kudryavtsevov/VM_T1/README.md

# VM-T1 F1Q — ESP32-C3 Super Mini

Отдельная ветка **`f1q-esp32-c3-super-mini`** для недорогого открытого таймера F1Q.
Исходный проект таймера — **Мстислав**, опубликован с его разрешения под Apache-2.0.
Основная ветка `main` сохраняет исходный проект ESP32-S3; эта ветка использует другую распиновку и логику старта.

## Что подготовлено

- ESP32-C3 Super Mini устанавливается на плату двумя рядами по 8 контактов, шаг 2,54 мм, междурядье 15,24 мм.
- Три сервопривода, отдельный ESC, кнопки ARM/START/OFF/RC DT.
- INA226: ток, напряжение, энергия; BMP280: относительная высота и максимум.
- Экспериментальный лимиттер по энергии и времени с блокировкой повторного запуска.
- Настройка через Wi-Fi. Концевики BACK/FRONT в F1Q не используются.

**Для двигателя около 7 А нужно физически заменить R100 на R010 (0,01 Ом, от 2 Вт).**
Рабочий предел 7,5 А, диапазон АЦП около 8,19 А. Пусковые пики и нагрев требуют стендового измерения.
Режим F1Q по умолчанию выключен. Это прототип, **одобрения EDIC и аппаратных испытаний нет**.

## Документация и плата

- [Размеры, ориентация двух рядов и GPIO C3](docs/C3_GEOMETRY.md).
- [Подключение R010, BMP280 и порядок испытаний](docs/F1Q.md).
- [Готовые модули в России](docs/BUY_RU.md).
- [KiCad, схема, Gerber и монтажный эскиз платы C3](hardware/c3-supermini-v1/README.md).
- [Лицензия и зависимости](LICENSING.md).

Старые PDF и `hardware/carrier-v1` относятся к исходному таймеру/S3 и не являются инструкцией для C3.

## Arduino IDE

Открыть `VM_T1/VM_T1.ino`. Папка и основной файл должны иметь одинаковое имя `VM_T1`.

1. В менеджер плат добавить `https://espressif.github.io/arduino-esp32/package_esp32_index.json`.
2. Установить **esp32 by Espressif Systems 2.0.11**.
3. Библиотеки: **ESP32Servo 1.1.2**, **ArduinoJson 7.4.3**, **Adafruit BMP280 Library 2.6.8**, **Adafruit BusIO 1.17.4**, **Adafruit Unified Sensor 1.1.15**.
4. Плата **ESP32C3 Dev Module**; USB CDC On Boot **Enabled**, Flash Mode **DIO**, Upload Speed **115200**. PSRAM для C3 не требуется.
5. Verify, затем выбрать порт и Upload. При необходимости входа в загрузчик удержать BOOT, нажать и отпустить RESET, затем отпустить BOOT.

```sh
arduino-cli compile --fqbn "esp32:esp32:esp32c3:CDCOnBoot=cdc,FlashMode=dio,UploadSpeed=115200" VM_T1
```

При включении со снятым ARM точка Wi-Fi работает три минуты. Повторно: снять ARM и держать OFF три секунды.
GPIO9/BOOT не занят периферией. Прошивка отклоняет сборку для S3, чтобы не прошить несовместимую распиновку.
Версии Core 3.x этой проверкой не подтверждены.

## Проверки

Arduino CLI 0.35.3: сборка C3 проверена — 806 276 байт Flash, 39 972 байта RAM. Подробности итоговых проверок — в `hardware/c3-supermini-v1/README.md`.
Автономные тесты расчёта энергии находятся в `tests/`. Проверка геометрии, назначения GPIO и совпадения схемы с платой — `tools/verify_c3.py`.
Проверки на компьютере не заменяют калибровку и испытания физического устройства.
