kudryavtsevov/VM_T1/LICENSING.md

# Лицензирование

Автор исходного проекта VM-T1 — **Мстислав**.
Подготовка к публикации выполняется с разрешения автора, о котором сообщил
сопровождающий репозитория. Выбранная лицензия — **Apache-2.0**.

Лицензия распространяется на исходный код и документацию этого проекта,
включая `VM_T1/VM_T1.ino`, `VM-T1_Руководство_пользователя.pdf`
и `Распайка.pdf`. Полный текст находится в [LICENSE](LICENSE),
сведения об авторстве — в [NOTICE](NOTICE).

Apache-2.0 допускает использование, изменение и продажу, включая закрытые
производные. При распространении необходимо соблюдать условия лицензии,
в том числе сохранять предусмотренные уведомления и обозначать изменения.
Лицензия не ограничивает цену готового устройства.

## Зависимости

В исходнике есть подключения библиотек, но сами библиотеки и точные версии не приложены.

- [Arduino Core for ESP32](https://github.com/espressif/arduino-esp32): основная лицензия LGPL-2.1; отдельные компоненты имеют собственные условия.
- [ESP32Servo](https://github.com/madhephaestus/ESP32Servo#license): LGPL-2.1-or-later.
- [ArduinoJson](https://arduinojson.org/): MIT.
- [Adafruit BMP280 Library](https://github.com/adafruit/Adafruit_BMP280_Library), 2.6.8: BSD, уведомление в исходниках библиотеки.
- [Adafruit Unified Sensor](https://github.com/adafruit/Adafruit_Sensor), 1.1.15: Apache-2.0.
- [Adafruit BusIO](https://github.com/adafruit/Adafruit_BusIO), 1.17.4: MIT.

Новые файлы прошивки, схема и плата-переходник распространяются под Apache-2.0. Библиотеки не включены в репозиторий; устанавливаются отдельно.

Apache-2.0 для проекта не отменяют условий зависимостей.
Перед распространением готовых бинарных прошивок нужно закрепить версии, проверить
лицензии реально включённых компонентов и обеспечить выполнение LGPL, в том числе
условий изменения/перелинковки библиотек. Это предварительная проверка, не полный
аудит бинарной сборки.

## Источник лицензии

[Официальный текст Apache License 2.0](https://www.apache.org/licenses/LICENSE-2.0.txt).
