kudryavtsevov/VM_T1/docs/BUY_RU.md

# Готовые модули и комплектующие в России

Ссылки проверялись в сентябре 2026; цена, наличие и комплектация меняются. Это платы-модули для Arduino/ESP32, не отдельные микросхемы.

| Что | Продавец | Что проверить |
|---|---|---|
| INA226 R100 | [Неглупый Дом](https://notshome.ru/?items=927) | готовый модуль с 0,1 Ом; для нашего двигателя заменить шунт |
| INA226 | [SMDX](https://smdx.ru/ina226) | название магазина SMDX не означает отдельную SMD-микросхему; уточнить шунт |
| INA226 | [AVRobot](https://www.avrobot.ru/product_info.php?products_id=7611) | вариант/наличие встроенного шунта уточнить |
| CJMCU-226 | [RoboParts](https://roboparts.ru/catalog/datchiki/datchiki_toka_i_napryazheniya/cjmcu-226-ina226/) | не полагаться на указанное «R100 до 8 А»: предел около 0,82 А |
| BMP280 3,3 В | [Элкотел](https://www.elcotel.ru/catalog/arduino/datchiki_i_moduli/139053/) | питание и подтяжки I²C 3,3 В |
| BMP280 Trema | [iArduino](https://iarduino.ru/shop/Sensory-Datchiki/barometr-trema-modul.html) | распиновка и адрес модуля |

Ваш INA226 уже есть: покупать другой не требуется, если его силовые контакты и дорожки пригодны для 7 А. Нужен R010 (10 мОм), не менее 2 Вт, 1% или точнее, с подходящим корпусом. Конкретный артикул замены пока не выбран: нужен размер установленного R100. Нельзя покупать по одной маркировке без проверки мощности и размера.

Также нужны ESP32-C3 Super Mini, BEC 5 В, ESC с совместимым сигналом 3,3 В, выводной резистор 47 кОм, кнопки START/OFF/RC DT, перемычка ARM, провода, плата-переходник. Для внешнего LED — резистор 1 кОм; для пищалки — модуль со своим драйвером. ESP вставляется в два разъёма 1×8 на плате C3; датчики подключаются короткими проводами и крепятся отдельно.
