kudryavtsevov/VM_T1/docs/F1Q.md

# INA226, BMP280 и экспериментальный режим F1Q

Версия 30 сентября 2026. Режим F1Q по умолчанию выключен. Исходный таймер — Мстислав; расширение датчиков и платы добавлено отдельно.

## Ваш модуль: заменить R100 на R010

Для заявленного двигателя около 7 А установленный R100 (0,1 Ом) непригоден: падение 0,7 В, мощность 4,9 Вт. INA226 измеряет только ±81,92 мВ. Это ограничение АЦП, а не калибровки.

По согласованному варианту замените R100 на **R010, 0,01 Ом, 1% или точнее, не менее 2 Вт**, подходящего размера. Размер и допустимую мощность определяют по конкретному резистору: маркировка R010 сама по себе их не задаёт. Уточните посадочное место перед покупкой. Замена потребует пайки одного SMD-резистора на готовом модуле; сама плата-переходник — выводная.

При 7 А: падение 70 мВ, нагрев 0,49 Вт. Теоретический предел — 8,192 А, программный рабочий предел — 7,5 А и 75 мВ. Проверить нужно полный ток, включая электронику и сервоприводы. Если пусковые пики превышают диапазон, нужен другой шунт и пересмотр калибровки. **С оставленным R100 новая прошивка будет завышать ток в 10 раз. Не включайте F1Q до физической замены.**

Основание: [INA226, документация TI](https://www.ti.com/lit/ds/symlink/ina226.pdf). Сведения продавцов «R100 до 8 А» не соответствуют этому диапазону АЦП.

## Подключение

Прошивка рассчитана на ESP32-C3 Super Mini. Питание датчиков и подтяжек I²C — **3,3 В**, общая земля, SDA GPIO2, SCL GPIO10. INA226: адрес 0x40; BMP280: 0x76 или 0x77, именно BMP280 (ID 0x58), не BME280. CSB у BMP280 должен быть подтянут к 3,3 В для I²C; на готовых модулях проверить перемычки/схему.

Силовая цепь: аккумулятор + → IN+ / R010 / IN− → ESC и вход BEC. Минус аккумулятора общий с ESC, BEC, ESP и датчиками. VBUS INA226 должен измерять **IN−**, нагрузочную сторону: программа добавляет падение на шунте для восстановления напряжения аккумулятора. Сначала проверьте прозвонкой заводское соединение VBUS; не перемыкайте IN+ и IN− через заводские дорожки. Силовые провода припаиваются к подходящим силовым контактам, не к гребёнке Dupont. Способность дорожек и контактов именно вашего модуля выдержать 7 А требуется проверить.

Ток двигателя через плату-переходник не проходит. BEC 5 В питает ESP и сервоприводы. Аккумулятор напрямую к 5V/3V3 подключать нельзя. Пока поддержаны измеряемые напряжения 1–16 В; для 4S полностью заряженных 16,8 В этот вариант не подходит. Не подключать одновременно USB и внешние 5 В к ESP32-C3 Super Mini без развязки источников.

| Сигнал | GPIO | Подключение |
|---|---:|---|
| Servo S/R/W | 4 / 5 / 6 | сигнал; питание от BEC |
| RC DT / OFF | 7 / 20 | замыкание на GND |
| START / ARM | 1 / 0 | кнопка / съёмная перемычка на GND |
| ESC | 3 | сигнал, общий GND; резистор 47 кОм на GND |
| Buzzer | 21 | управляющий вход модуля с драйвером |
| LED | 8 | встроенный синий, активный LOW |
| SDA / SCL | 2 / 10 | оба датчика параллельно |

[Геометрия и ориентация ESP32-C3 Super Mini](C3_GEOMETRY.md): два ряда по 8 контактов. GPIO9/BOOT оставить свободным. Плата содержит подтяжки SDA/SCL 4,7 кОм к 3,3 В; учесть параллельные подтяжки на готовых модулях.

## Настройка и запуск

Wi-Fi включается при подаче питания со снятым ARM на три минуты; повторно — держать OFF три секунды при снятом ARM.

Откройте раздел «INA226 / BMP280 / F1Q» в веб-интерфейсе. Задайте массу, 2 или 3 Дж/г, запас энергии, время, PWM ESC и измеренное сопротивление R010. Сохранение вступает в силу после перезапуска. Высота BMP280 относительная: ноль задаётся на земле, автоматически обновляется при подготовке START. Она показывается вместе с максимумом, но не управляет мотором и не сохраняется после выключения.

1. При включении ARM снят, ESC получает 1000 мкс. Проверить, что это действительно остановка вашего ESC.
2. Установить ARM; Wi-Fi отключается. Держать START не менее секунды.
3. Отпустить START: запускаются мотор, интегрирование энергии и программа сервоприводов.
4. Мотор останавливается по энергии, времени, снятию ARM, RC DT, OFF, недостоверным или устаревшим более 30 мс данным INA226. Повторный запуск заблокирован до перезапуска питания. После перезапуска требуется снова снять ARM.

Для калибровки сначала использовать известную резистивную нагрузку, независимый амперметр и вольтметр. Проверить несколько токов и напряжений, нагрев модуля, направление тока, обрыв I²C и снятие ARM. Затем испытать двигатель в закреплённом стенде, измерив пусковой ток внешним прибором с достаточным быстродействием: INA226 за своим диапазоном достоверный пик не покажет. Работа с пропеллером требует отдельного защищённого стенда; первоначальную настройку выполнять без пропеллера.

## Границы применения

В [январской редакции FAI 2026](https://www.fai.org/sites/default/files/document/file/SC4_volume_CIAM_F1_FreeFlight_2026.pdf) F1Q использует 3 Дж/г при расчётной массе не более 550 г и до 30 с работы; предусмотрен сниженный вариант 2 Дж/г и 20 с. Здесь задан запас: максимум 29,5/19,5 с, вычитаемый энергетический резерв. Перед соревнованием проверить действующую редакцию и условия организатора.

**Это экспериментальная прошивка, не одобренный EDIC спортивный лимиттер.** Нет независимого аппаратного отключения при зависании CPU, интерфейса проверки SET, учёта энергии после команды остановки ESC и подтверждённой на стенде точности/задержки отключения. Запас энергии не заменяет эти проверки. Настройки и измерения пока не образуют журнал полёта. Стендовая проверка на физическом оборудовании ещё не выполнена.
