kudryavtsevov/VM_T1/Распайка.pdf

════════════════════════════════════════════════════════════════════════ ТАБЛИЦА ПОДКЛЮЧЕНИЯ таймера ════════════════════════════════════════════════════════════════════════

КОМПОНЕНТ | ПРОВОД | КУДА ПОДКЛЮЧИТЬ
──────────────────────────────────────────────────────────────
Servo S | Сигнал (оранж) | GPIO 4
| Питание (+) | BEC 5В
| Земля (−) | GND
Servo R | Сигнал (оранж) | GPIO 5
| Питание (+) | BEC 5В
| Земля (−) | GND
Servo W | Сигнал (оранж) | GPIO 6
| Питание (+) | BEC 5В
| Земля (−) | GND
Концевик 1 BACK | Контакт 1 | GPIO 7
| Контакт 2 | GND
Концевик 2 FRONT | Контакт 1 | GPIO 8
| Контакт 2 | GND
Кнопка DT | Контакт 1 | GPIO 3
| Контакт 2 | GND
Зуммер | (+) | GPIO 9
| (−) | GND
BEC 5В | IN+ | LiPo (+)
| IN− | LiPo (−)
| OUT+ | Сервы (+), ESP 5V
| OUT− | GND
Конденсатор | (+) | BEC OUT+
| (−) | BEC OUT−
