kudryavtsevov/VM_T1/hardware/c3-supermini-v1/vm-t1-f1q-c3-v1.kicad_pcb

## KiCad design hardware/c3-supermini-v1/vm-t1-f1q-c3-v1.kicad_pcb (2026-09-30)

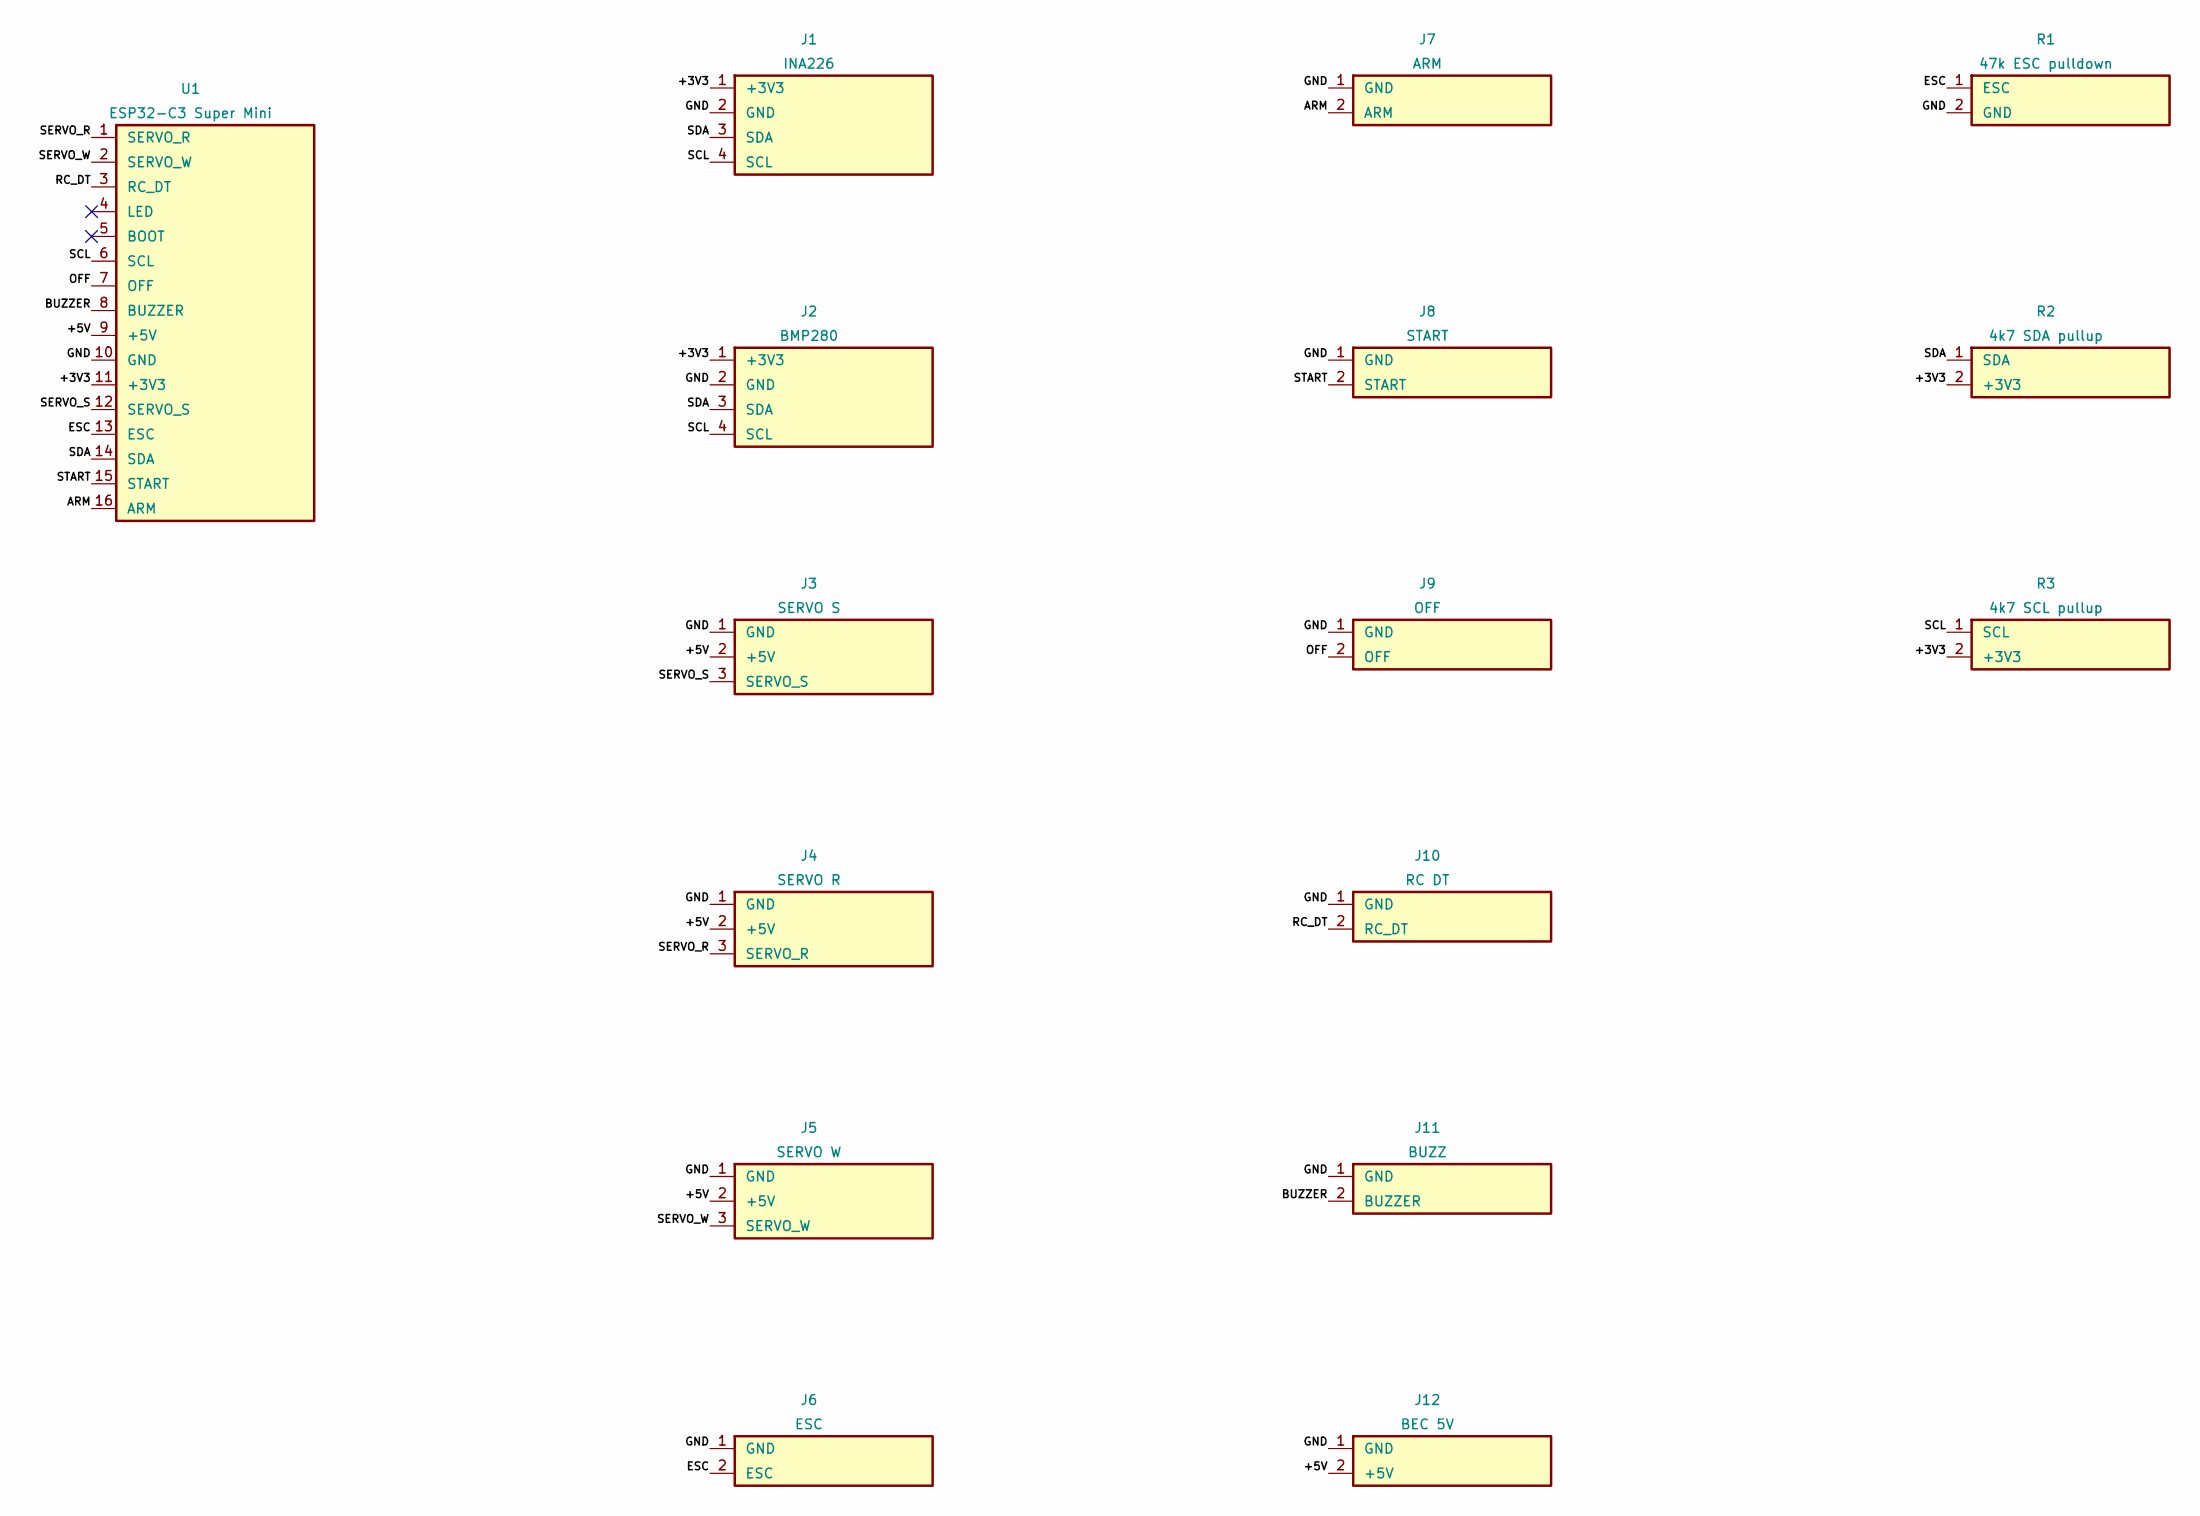
[picture p4: schematic vm-t1-f1q-c3-v1.kicad_sch]

Parts:
J1: INA226; J1
J2: BMP280; J2
J3: SERVO S; J3
J4: SERVO R; J4
J5: SERVO W; J5
J6: ESC; J6
J7: ARM; J7
J8: START; J8
J9: OFF; J9
J10: RC DT; J10
J11: BUZZ; J11
J12: BEC 5V; J12
R1: 47k ESC pulldown; R1
R2: 4k7 SDA pullup; R2
R3: 4k7 SCL pullup; R3
U1: ESP32-C3 Super Mini; U1

Connections:
+3V3: J1.1 (+3V3), J2.1 (+3V3), R2.2 (+3V3), R3.2 (+3V3), U1.11 (+3V3)
+5V: J3.2 (+5V), J4.2 (+5V), J5.2 (+5V), J12.2 (+5V), U1.9 (+5V)
ARM: J7.2 (ARM), U1.16 (ARM)
BOOT: U1.5 (BOOT)
BUZZER: J11.2 (BUZZER), U1.8 (BUZZER)
ESC: J6.2 (ESC), R1.1 (ESC), U1.13 (ESC)
GND: J1.2 (GND), J2.2 (GND), J3.1 (GND), J4.1 (GND), J5.1 (GND), J6.1 (GND), J7.1 (GND), J8.1 (GND), J9.1 (GND), J10.1 (GND), J11.1 (GND), J12.1 (GND), R1.2 (GND), U1.10 (GND)
LED: U1.4 (LED)
OFF: J9.2 (OFF), U1.7 (OFF)
RC_DT: J10.2 (RC_DT), U1.3 (RC_DT)
SCL: J1.4 (SCL), J2.4 (SCL), R3.1 (SCL), U1.6 (SCL)
SDA: J1.3 (SDA), J2.3 (SDA), R2.1 (SDA), U1.14 (SDA)
SERVO_R: J4.3 (SERVO_R), U1.1 (SERVO_R)
SERVO_S: J3.3 (SERVO_S), U1.12 (SERVO_S)
SERVO_W: J5.3 (SERVO_W), U1.2 (SERVO_W)
START: J8.2 (START), U1.15 (START)

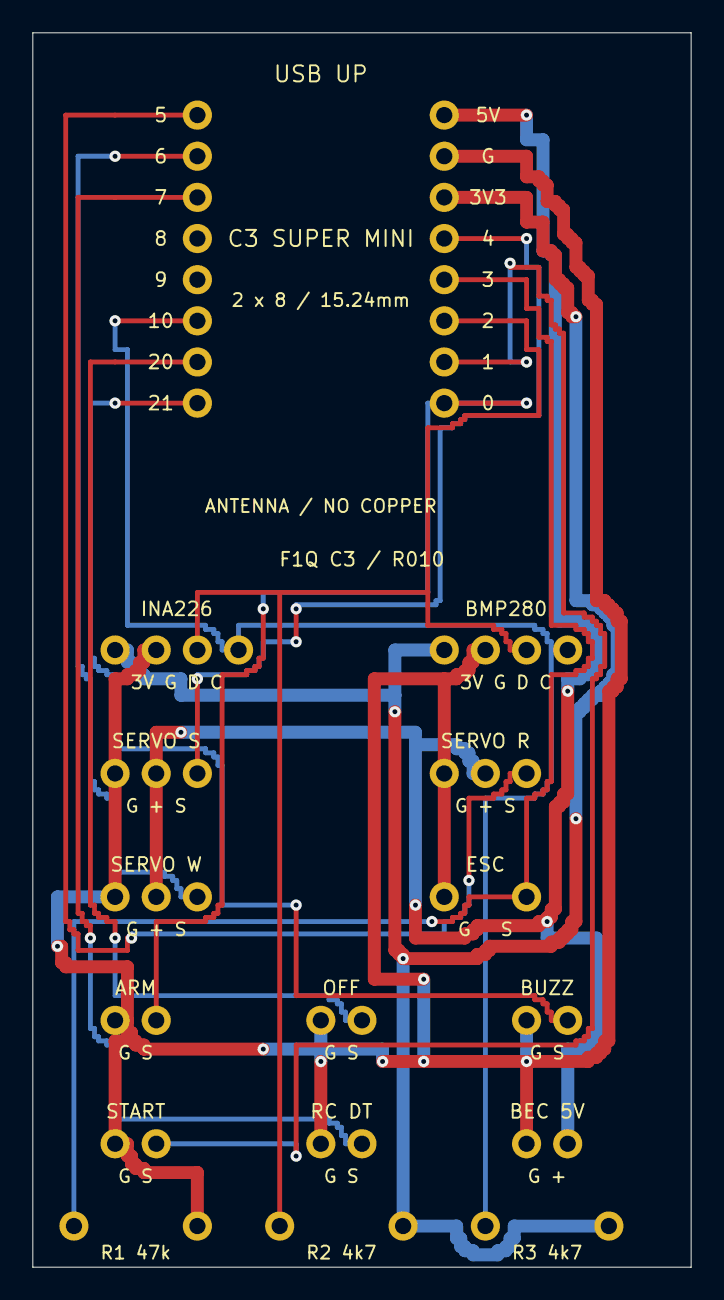
[picture p5: board vm-t1-f1q-c3-v1.kicad_pcb from above]

Board: 2 copper layers, 40.6 x 76.2 mm, 16 parts (0 on the bottom side), 14 nets.
