kudryavtsevov/VM_T1/hardware/carrier-v1/vm-t1-carrier-v1.kicad_pcb

## KiCad design hardware/carrier-v1/vm-t1-carrier-v1.kicad_pcb (2026-09-30)

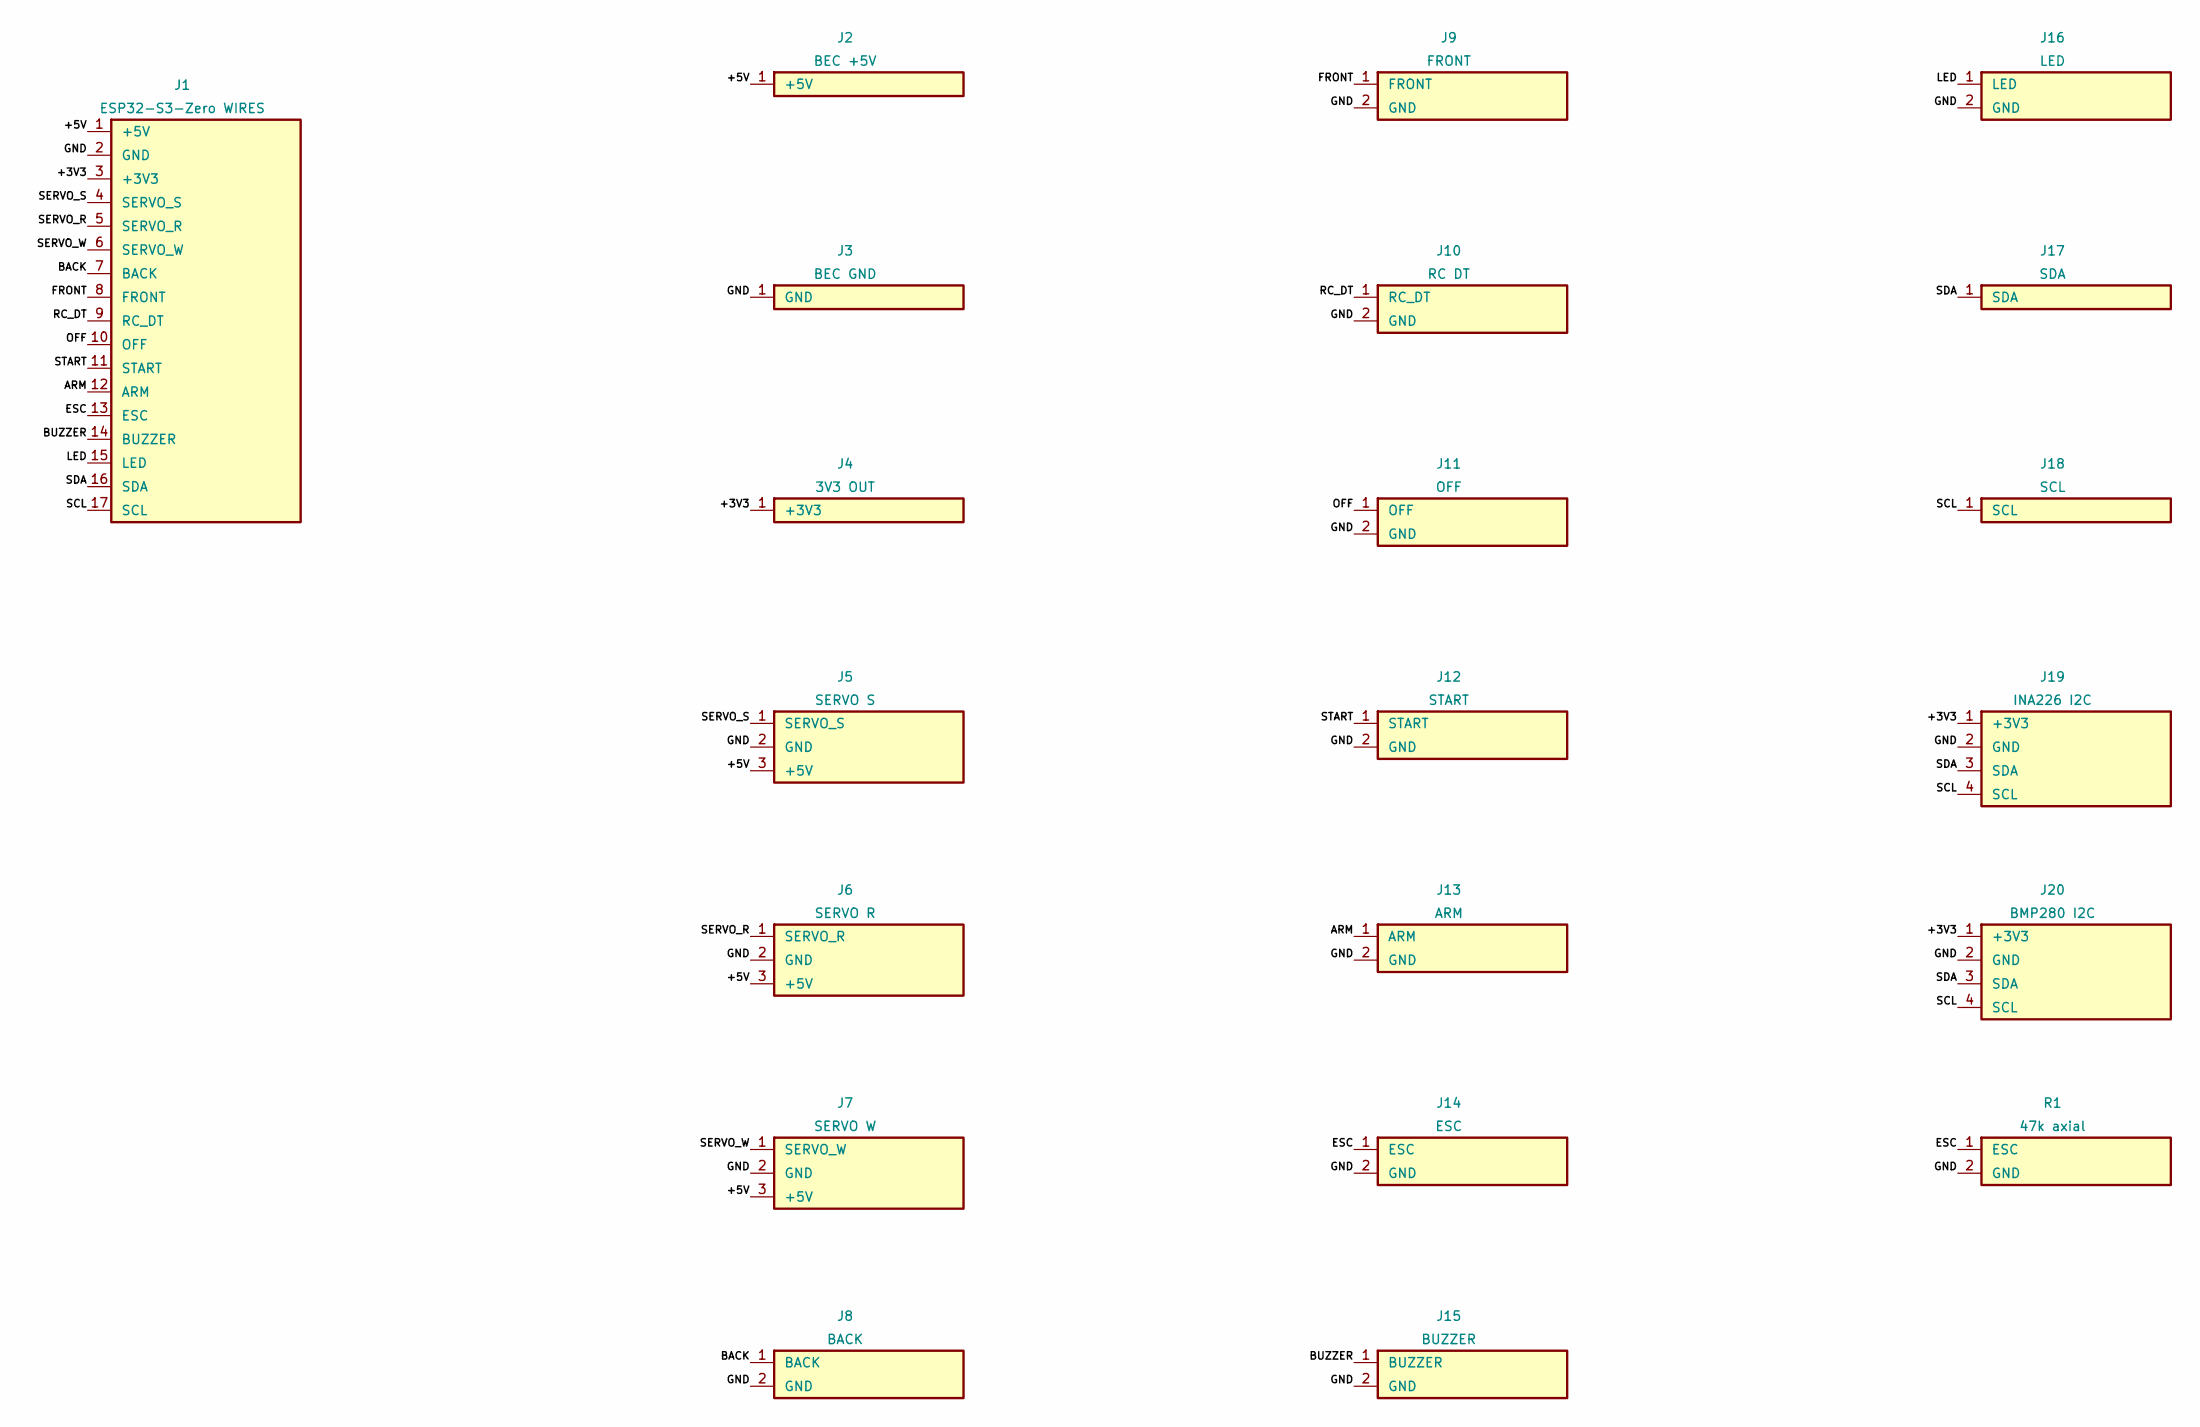
[picture p6: schematic vm-t1-carrier-v1.kicad_sch]

Parts:
J1: ESP32-S3-Zero WIRES; J1
J2: BEC +5V; J2
J3: BEC GND; J3
J4: 3V3 OUT; J4
J5: SERVO S; J5
J6: SERVO R; J6
J7: SERVO W; J7
J8: BACK; J8
J9: FRONT; J9
J10: RC DT; J10
J11: OFF; J11
J12: START; J12
J13: ARM; J13
J14: ESC; J14
J15: BUZZER; J15
J16: LED; J16
J17: SDA; J17
J18: SCL; J18
J19: INA226 I2C; J19
J20: BMP280 I2C; J20
R1: 47k axial; R1

Connections:
+3V3: J1.3 (+3V3), J4.1, J19.1 (+3V3), J20.1 (+3V3)
+5V: J1.1 (+5V), J2.1, J5.3 (+5V), J6.3 (+5V), J7.3 (+5V)
ARM: J1.12 (ARM), J13.1 (ARM)
BACK: J1.7 (BACK), J8.1 (BACK)
BUZZER: J1.14 (BUZZER), J15.1 (BUZZER)
ESC: J1.13 (ESC), J14.1 (ESC), R1.1 (ESC)
FRONT: J1.8 (FRONT), J9.1 (FRONT)
GND: J1.2 (GND), J3.1, J5.2 (GND), J6.2 (GND), J7.2 (GND), J8.2 (GND), J9.2 (GND), J10.2 (GND), J11.2 (GND), J12.2 (GND), J13.2 (GND), J14.2 (GND), J15.2 (GND), J16.2 (GND), J19.2 (GND), J20.2 (GND), R1.2 (GND)
LED: J1.15 (LED), J16.1 (LED)
OFF: J1.10 (OFF), J11.1 (OFF)
RC_DT: J1.9 (RC_DT), J10.1 (RC_DT)
SCL: J1.17 (SCL), J18.1, J19.4 (SCL), J20.4 (SCL)
SDA: J1.16 (SDA), J17.1, J19.3 (SDA), J20.3 (SDA)
SERVO_R: J1.5 (SERVO_R), J6.1 (SERVO_R)
SERVO_S: J1.4 (SERVO_S), J5.1 (SERVO_S)
SERVO_W: J1.6 (SERVO_W), J7.1 (SERVO_W)
START: J1.11 (START), J12.1 (START)

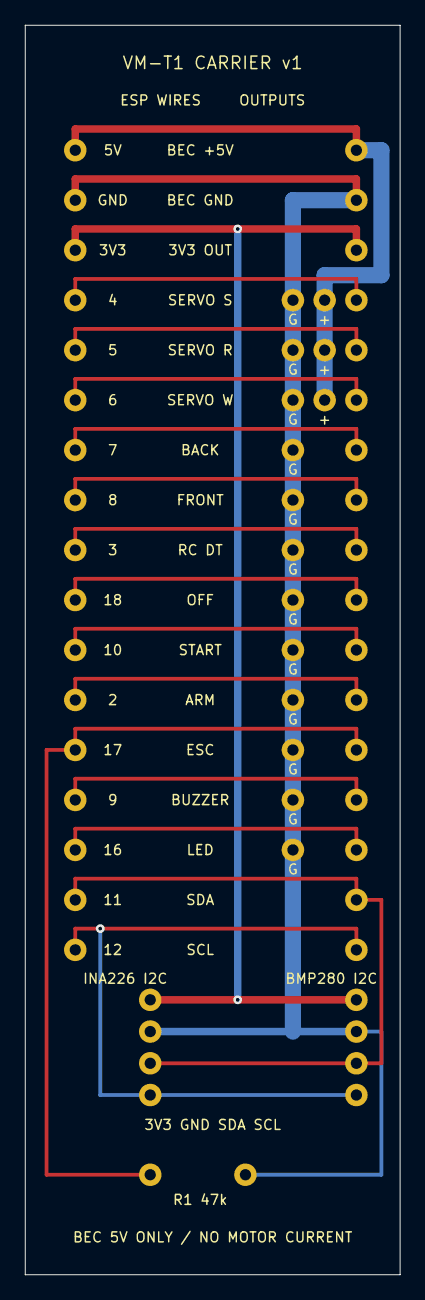
[picture p7: board vm-t1-carrier-v1.kicad_pcb from above]

Board: 2 copper layers, 30.0 x 100.0 mm, 21 parts (0 on the bottom side), 17 nets.
