kudryavtsevov/VM_T1/(commit log)

2026-09-24 Initial import of VM-T1 timer and licensing proposal
2026-09-24 Package VM-T1 as Arduino sketch and document verified build
2026-09-30 Add experimental F1Q firmware and ESP32-C3 Super Mini carrier
    [vm-t1-carrier-v1-B_Cu.gbl, vm-t1-carrier-v1-B_Mask.gbs, vm-t1-carrier-v1-B_Silkscreen.gbo, vm-t1-carrier-v1-Edge_Cuts.gm1, vm-t1-carrier-v1-F_Cu.gtl, vm-t1-carrier-v1-F_Mask.gts, vm-t1-carrier-v1-F_Silkscreen.gto, vm-t1-carrier-v1-job.gbrjob]
